First-Order-RoboCup-SSL/Dribbler_FOC_Driver/README.md

# Dribbler_FOC_Driver
FOC Driver

Version 1
