First-Order-RoboCup-SSL/Dribbler_FOC_Driver/dribbler_driver_ver.6/foc_driver_BOM.xlsx

Sheet: RLC
Reference | Value | Datasheet | Footprint | Qty | DNP
C1,C29,C40 | 100uF | ~ | Capacitor_SMD:C_0603_1608Metric_Pad1.08x0.95mm_HandSolder | 3
C2 | 1u | ~ | Capacitor_SMD:C_0603_1608Metric_Pad1.08x0.95mm_HandSolder | 1
C3,C4,C5,C6 | 0.01u | ~ | Capacitor_SMD:C_0603_1608Metric_Pad1.08x0.95mm_HandSolder | 4
C10,C11,C12,C13,C15,C19 | 4.7uF | ~ | Capacitor_SMD:C_0603_1608Metric_Pad1.08x0.95mm_HandSolder | 6
C14,C17,C22,C23,C24,C26,C36,C38,C39 | 100nF | ~ | Capacitor_SMD:C_0603_1608Metric_Pad1.08x0.95mm_HandSolder | 9
C16 | 1uF | ~ | Capacitor_SMD:C_0603_1608Metric_Pad1.08x0.95mm_HandSolder | 1
C18,C20,C25,C27 | 10u | ~ | Capacitor_SMD:C_0603_1608Metric_Pad1.08x0.95mm_HandSolder | 4
C21,C28 | 20pF | ~ | Capacitor_SMD:C_0603_1608Metric_Pad1.08x0.95mm_HandSolder | 2
C34,C35,C41,C42 | 10uF | ~ | Capacitor_SMD:C_0603_1608Metric_Pad1.08x0.95mm_HandSolder | 4
C37 | 30pF | ~ | Capacitor_SMD:C_0603_1608Metric_Pad1.08x0.95mm_HandSolder | 1
R1 | 0 |  | Resistor_SMD:R_0603_1608Metric_Pad0.98x0.95mm_HandSolder | 1
R2,R4,R6 | 4.7k | ~ | Resistor_SMD:R_0603_1608Metric_Pad0.98x0.95mm_HandSolder | 3
R3,R5,R9 | 100 | ~ | Resistor_SMD:R_0603_1608Metric_Pad0.98x0.95mm_HandSolder | 3
R7,R8 | 0.01 | ~ | Resistor_SMD:R_0603_1608Metric_Pad0.98x0.95mm_HandSolder | 2
R10 | 1k | ~ | Resistor_SMD:R_0603_1608Metric_Pad0.98x0.95mm_HandSolder | 1
R11,R12,R13,R14,R15,R20 | 2.2 | ~ | Resistor_SMD:R_0603_1608Metric_Pad0.98x0.95mm_HandSolder | 6
R16,R17,R21,R22,R23,R24,R28,R29,R30 | 10k | ~ | Resistor_SMD:R_0603_1608Metric_Pad0.98x0.95mm_HandSolder | 9
R18 | 120 | ~ | Resistor_SMD:R_0603_1608Metric_Pad0.98x0.95mm_HandSolder | 1
R19 | 470 | ~ | Resistor_SMD:R_0603_1608Metric_Pad0.98x0.95mm_HandSolder | 1
R25 | 100k | ~ | Resistor_SMD:R_0603_1608Metric_Pad0.98x0.95mm_HandSolder | 1
R26 | 47k | ~ | Resistor_SMD:R_0603_1608Metric_Pad0.98x0.95mm_HandSolder | 1
R27 | 249k | ~ | Resistor_SMD:R_0603_1608Metric_Pad0.98x0.95mm_HandSolder | 1
RN2 | R_Pack04_SIP_Split | http://www.vishay.com/docs/31509/csc.pdf | R_array_4:0402*4_r | 1
L2 | 15uH | ~ | Inductor_SMD:L_Neosid_SM-NE127_HandSoldering | 1

Sheet: MOS&Diode
Reference | Value | Datasheet | Footprint | Qty | DNP
D2, D6 | LED |  | LED_SMD:LED_0603_1608Metric_Pad1.05x0.95mm_HandSolder | 2
D1 | BZT52B20-G |  | Diode_SMD:D_SOD-123 | 1
D3, D4, D5 | 1N5819WS |  | Diode_SMD:D_SOD-323 | 3
Q1,Q2,Q5,Q6,Q9,Q10 | WSD4070DN |  | Package_DFN_QFN:DFN-8-1EP_3x3mm_P0.5mm_EP1.65x2.38mm | 6

Sheet: Connector
Reference | Value | Datasheet | Footprint | Qty | DNP
P1 | GH1.25-8 |  | Connector_JST:JST_GH_BM02B-GHS-TBT_1x02-1MP_P1.25mm_Vertical | 1
J1 | SWD_Debug |  | Connector_PinHeader_2.54mm:PinHeader_1x05_P2.54mm_Vertical | 1
J3,J4 | Conn_01x02_MountingPin |  | Connector_JST:JST_GH_BM02B-GHS-TBT_1x02-1MP_P1.25mm_Vertical | 2
JP1 | SolderJumper_2_Open |  | Jumper:SolderJumper-2_P1.3mm_Open_RoundedPad1.0x1.5mm | 1
USART1 | GH1.25-3 |  | Connector_PinHeader_2.54mm:PinHeader_1x03_P2.54mm_Vertical | 1

Sheet: MCU
Reference | Value | Datasheet | Footprint | Qty | DNP
RY8411 |  |  | SOT-23-6 | 1
U1 | STM32F103C8Tx | http://www.st.com/st-web-ui/static/active/en/resource/technical/document/datasheet/CD00161566.pdf | Package_QFP:LQFP-48_7x7mm_P0.5mm | 1
U2,U3 | INA240A2PWR |  | SCH_DengFO-easyedapro:TSSOP-8_L4.4-W3.0-P0.65-LS6.4-BL | 2
U5 | SIT1042T | http://www.ti.com/lit/ds/symlink/tcan337.pdf | Package_SO:SOP-8_3.9x4.9mm_P1.27mm | 1
U6 | XC6210B332MR | https://www.torexsemi.com/file/xc6210/XC6210.pdf | Package_TO_SOT_SMD:SOT-23-5 | 1
U8 | EG2133 |  | TSSOP-20 | 1
Y1 | Crystal 8MHz 20pf | ~ | Crystal:Crystal_SMD_5032-2Pin_5.0x3.2mm_HandSoldering | 1
