First-Order-RoboCup-SSL/Dribbler_FOC_Driver/dribbler_driver_ver.6/JST - PH - SMD (R) - 8Pin - 2.00mm.stp

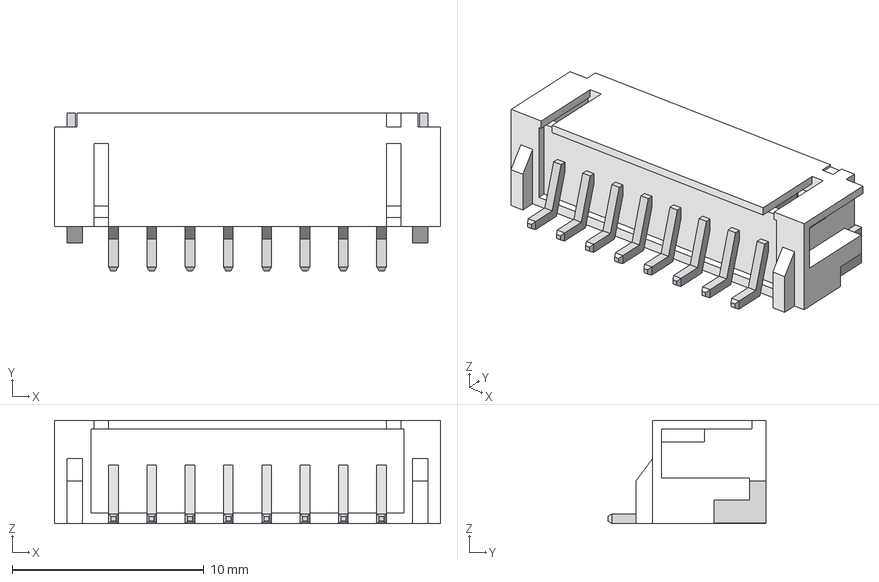
[picture p1: CAD file, 2026-01-09]
dribbler_driver_ver.6/JST - PH - SMD (R) - 8Pin - 2.00mm.stp
20.1 x 8.26 x 5.38 mm
