First-Order-RoboCup-SSL/Dribbler_FOC_Driver/dribbler_driver_ver.6/dribbler_driver.step

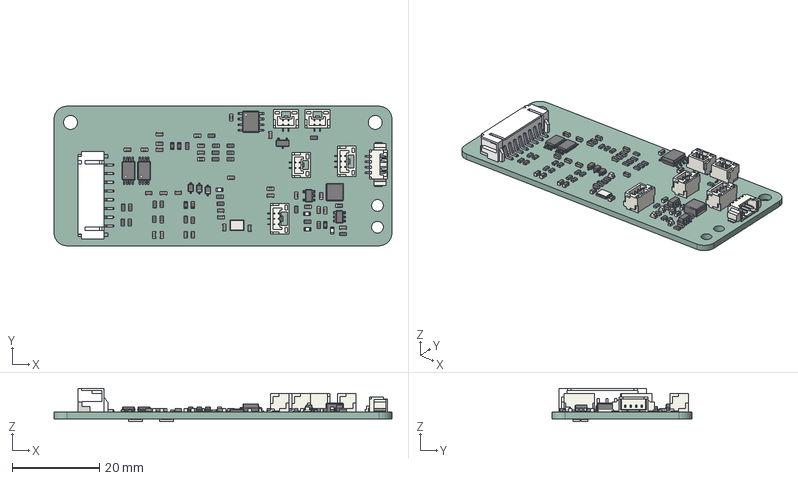
[picture p2: CAD file, 2026-01-09]
dribbler_driver_ver.6/dribbler_driver.step
77.7 x 32.1 x 7.61 mm
C_0603_1608Metric x 32
D_SOD-323 x 3
R_0603_1608Metric x 30
JST_GH_BM02B-GHS-TBT_1x02-1MP_P1.25mm_Vertical x 3
SOT-23-6
SOT-23
TSSOP-8_4.4x3mm_P0.65mm x 2
SOT-23-5
JST - PH - SMD (R) - 8Pin - 2.00mm
Molex_PicoBlade_53261-0471_1x04-1MP_P1.25mm_Horizontal
JST_GH_BM03B-GHS-TBT_1x03-1MP_P1.25mm_Vertical x 2
L_Changjiang_FNR4020S
LED_0603_1608Metric x 4
SOIC-8_3.9x4.9mm_P1.27mm
Crystal_SMD_3225-4Pin_3.2x2.5mm
R_1206_3216Metric x 2
dribbler_driver_PCB
