First-Order-RoboCup-SSL/Dribbler_FOC_Driver/(list of files, cad)

Other CAD files:
dribbler_driver_ver.6/dribbler_driver.DXF
