First-Order-RoboCup-SSL/Dribbler_FOC_Driver/(list of files, drawings)

Other design files:
Original_DENG_FOC/PCB_DengFOC V3PRO.epro
Original_DENG_FOC/SCH_DengFOC V3 pro.epro
