First-Order-RoboCup-SSL/Dribbler_FOC_Driver/dribbler_driver_ver.6/dribbler_driver.kicad_pcb

## KiCad design dribbler_driver_ver.6/dribbler_driver.kicad_pcb (2026-01-09)

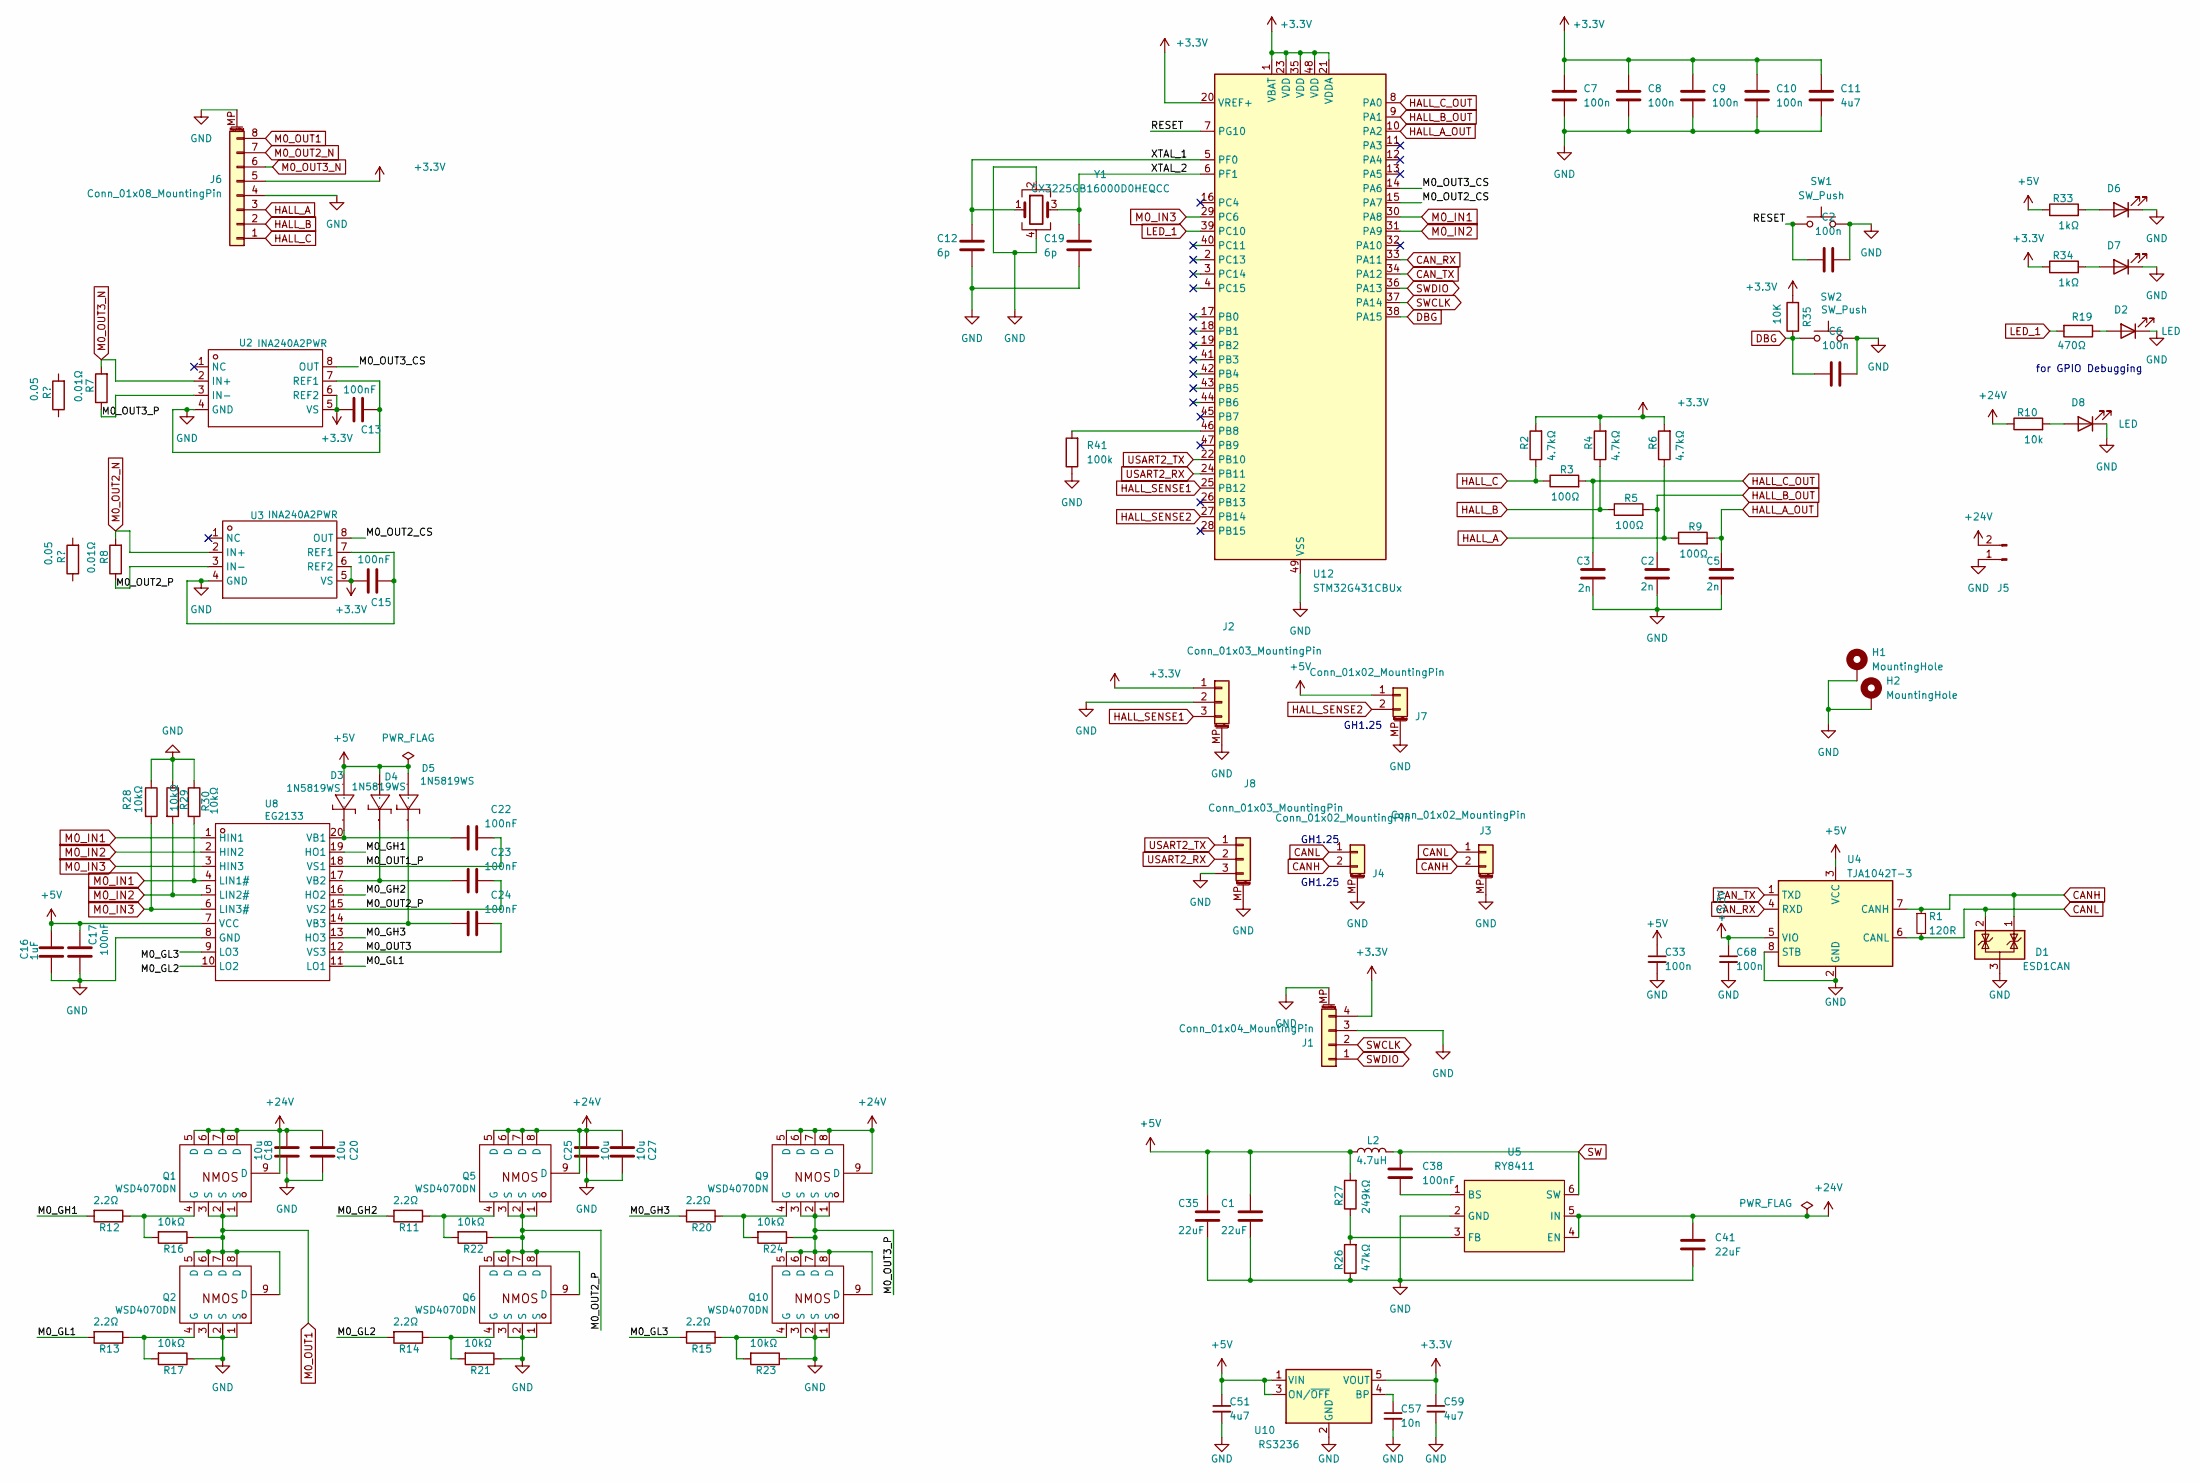
[picture p3: schematic dribbler_driver.kicad_sch, Dribbler FOC Driver]

Parts:
C1, C35, C41: 22uF; C_0603_1608Metric_Pad1.08x0.95mm_HandSolder
C2, C6, C7, C8, C9, C10, C33, C68: 100n; C_0603_1608Metric
C3, C5: 2n; C_0603_1608Metric_Pad1.08x0.95mm_HandSolder
C11, C51, C59: 4u7; C_0603_1608Metric
C12, C19: 6p; C_0603_1608Metric
C13, C15, C17, C22, C23, C24, C38: 100nF; C_0603_1608Metric_Pad1.08x0.95mm_HandSolder
C16: 1uF; C_0603_1608Metric_Pad1.08x0.95mm_HandSolder
C18, C20, C25, C27: 10u; C_0603_1608Metric_Pad1.08x0.95mm_HandSolder
C57: 10n; C_0603_1608Metric
D1: ESD1CAN; SOT-23
D2, D6, D7, D8: LED; LED_0603_1608Metric_Pad1.05x0.95mm_HandSolder
D3, D4, D5: 1N5819WS; D_SOD-323_HandSoldering; Manufacturer Part 1N5819WS
H1, H2: MountingHole; MountingHole_3.2mm_M3_Pad
J1: Conn_01x04_MountingPin; Molex_PicoBlade_53261-0471_1x04-1MP_P1.25mm_Horizontal
J2, J8: Conn_01x03_MountingPin; JST_GH_BM03B-GHS-TBT_1x03-1MP_P1.25mm_Vertical
J3, J4, J7: Conn_01x02_MountingPin; JST_GH_BM02B-GHS-TBT_1x02-1MP_P1.25mm_Vertical
J5: Conn_01x02_Pin; AMASS_XT30U-M_1x02_P5.0mm_Vertical
J6: Conn_01x08_MountingPin; JST_PH_S8B-PH-SM4-TB_1x08-1MP_P2.00mm_Horizontal
L2: 4.7uH; L_Changjiang_FNR4020S
Q1, Q2, Q5, Q6, Q9, Q10: WSD4070DN; DFN-8-1EP_3x3mm_P0.5mm_EP1.65x2.38mm; Manufacturer Part WSD4070DN
R1: 120R; R_0603_1608Metric
R2, R4, R6: 4.7kΩ; R_0603_1608Metric_Pad0.98x0.95mm_HandSolder
R3, R5, R9: 100Ω; R_0603_1608Metric_Pad0.98x0.95mm_HandSolder
R7, R8: 0.01Ω; R_1206_3216Metric
R10: 10k; R_0603_1608Metric_Pad0.98x0.95mm_HandSolder
R11, R12, R13, R14, R15, R20: 2.2Ω; R_0603_1608Metric_Pad0.98x0.95mm_HandSolder
R16, R17, R21, R22, R23, R24, R28, R29, R30: 10kΩ; R_0603_1608Metric_Pad0.98x0.95mm_HandSolder
R19: 470Ω; R_0603_1608Metric_Pad0.98x0.95mm_HandSolder
R26: 47kΩ; R_0603_1608Metric_Pad0.98x0.95mm_HandSolder
R27: 249kΩ; R_0603_1608Metric_Pad0.98x0.95mm_HandSolder
R33, R34: 1kΩ; R_0603_1608Metric_Pad0.98x0.95mm_HandSolder
R35: 10K; R_0603_1608Metric_Pad0.98x0.95mm_HandSolder
R41: 100k; R_0603_1608Metric
SW1, SW2: SW_Push; SW_SPST_SKQG_WithoutStem
U2, U3: INA240A2PWR; TSSOP-8_4.4x3mm_P0.65mm; Manufacturer Part INA240A2PWR
U4: TJA1042T-3; SOIC-8_3.9x4.9mm_P1.27mm
U5: RY8411; SOT-23-6_Handsoldering
U8: EG2133; TSSOP-20-1EP_4.4x6.5mm_P0.65mm_EP2.15x3.35mm; Manufacturer Part EG2133
U10: RS3236; SOT-23-5
U12: STM32G431CBUx; QFN-48-1EP_7x7mm_P0.5mm_EP5.6x5.6mm
Y1: CX3225GB16000D0HEQCC; Crystal_SMD_3225-4Pin_3.2x2.5mm

Connections:
+3.3V: C7.1, C8.1, C9.1, C10.1, C11.1, C13.1, C15.1, C59.1, C68.1, J1.4, J2.1, J6.5, R2.2, R4.2, R6.2, R34.1, R35.2, U2.5 (VS), U2.6 (REF2), U3.5 (VS), U3.6 (REF2), U4.5 (VIO), U10.5 (VOUT), U12.1 (VBAT), U12.20 (VREF+), U12.21 (VDDA), U12.23 (VDD), U12.35 (VDD), U12.48 (VDD)
+5V: C1.1, C16.1, C17.1, C33.1, C35.1, C51.1, D3.2 (A), D4.2 (A), D5.2 (A), J7.1, L2.1, R27.2, R33.1, U4.3 (VCC), U8.7 (VCC), U10.1 (VIN), U10.3 (ON/~OFF)
+24V: C18.1, C20.1, C25.1, C27.1, C41.1, J5.2, Q1.5 (D), Q1.6 (D), Q1.7 (D), Q1.8 (D), Q1.9 (D), Q5.5 (D), Q5.6 (D), Q5.7 (D), Q5.8 (D), Q5.9 (D), Q9.5 (D), Q9.6 (D), Q9.7 (D), Q9.8 (D), Q9.9 (D), R10.1, U5.4 (EN), U5.5 (IN)
/M0_GH1: R12.2, U8.19 (HO1)
/M0_GH2: R11.2, U8.16 (HO2)
/M0_GH3: R20.2, U8.13 (HO3)
/M0_GL1: R13.2, U8.11 (LO1)
/M0_GL2: R14.2, U8.10 (LO2)
/M0_GL3: R15.2, U8.9 (LO3)
/M0_OUT1_P: C22.1, U8.18 (VS1)
/M0_OUT2_CS: U3.8 (OUT), U12.15 (PA7)
/M0_OUT2_P: C23.1, Q5.1 (S), Q5.2 (S), Q5.3 (S), Q6.5 (D), Q6.6 (D), Q6.7 (D), Q6.8 (D), Q6.9 (D), R8.1, R22.1, U3.3 (IN-), U8.15 (VS2)
/M0_OUT3: C24.1, U8.12 (VS3)
/M0_OUT3_CS: U2.8 (OUT), U12.14 (PA6)
/M0_OUT3_P: Q9.1 (S), Q9.2 (S), Q9.3 (S), Q10.5 (D), Q10.6 (D), Q10.7 (D), Q10.8 (D), Q10.9 (D), R7.1, R24.1, U2.3 (IN-)
/XTAL_1: C12.1, U12.5 (PF0), Y1.1
/XTAL_2: C19.1, U12.6 (PF1), Y1.3
CANH: D1.1 (K), J3.2, J4.2, R1.1, U4.7 (CANH)
CANL: D1.2 (K), J3.1, J4.1, R1.2, U4.6 (CANL)
CAN_RX: U4.4 (RXD), U12.33 (PA11)
CAN_TX: U4.1 (TXD), U12.34 (PA12)
DBG: C6.1, R35.1, SW2.1, U12.38 (PA15)
GND: C1.2, C2.2, C3.1, C5.2, C6.2, C7.2, C8.2, C9.2, C10.2, C11.2, C12.2, C13.2, C15.2, C16.2, C17.2, C18.2, C19.2, C20.2, C25.2, C27.2, C33.2, C35.2, C41.2, C51.2, C57.2, C59.2, C68.2, D1.3 (A), D2.1 (K), D6.1 (K), D7.1 (K), D8.1 (K), H1.1, H2.1, J1.3, J1.MP (MountPin), J2.2, J2.MP (MountPin), J3.MP (MountPin), J4.MP (MountPin), J5.1, J6.4, J6.MP (MountPin), J7.MP (MountPin), J8.3, J8.MP (MountPin), Q2.1 (S), Q2.2 (S), Q2.3 (S), Q6.1 (S), Q6.2 (S), Q6.3 (S), Q10.1 (S), Q10.2 (S), Q10.3 (S), R17.1, R21.1, R23.1, R26.1, R28.1, R29.1, R30.1, R41.1, SW1.2, SW2.2, U2.4 (GND), U2.7 (REF1), U3.4 (GND), U3.7 (REF1), U4.2 (GND), U4.8 (STB), U5.2 (GND), U8.8 (GND), U8.21, U10.2 (GND), U12.49 (VSS), Y1.2, Y1.4; also elsewhere on the board
HALL_A: J6.3, R6.1, R9.1
HALL_A_OUT: C5.1, R9.2, U12.10 (PA2)
HALL_B: J6.2, R4.1, R5.1
HALL_C: J6.1, R2.1, R3.1
HALL_C_OUT: C3.2, R3.2, U12.8 (PA0)
HALL_SENSE1: J2.3, U12.25 (PB12)
HALL_SENSE2: J7.2, U12.27 (PB14)
LED_1: R19.2, U12.39 (PC10)
M0_IN1: R30.2, U8.1 (HIN1), U8.4 (LIN1#), U12.30 (PA8)
M0_IN2: R29.2, U8.2 (HIN2), U8.5 (LIN2#), U12.31 (PA9)
M0_IN3: R28.2, U8.3 (HIN3), U8.6 (LIN3#), U12.29 (PC6)
M0_OUT1: J6.8, Q1.1 (S), Q1.2 (S), Q1.3 (S), Q2.5 (D), Q2.6 (D), Q2.7 (D), Q2.8 (D), Q2.9 (D), R16.1
M0_OUT2_N: J6.7, R8.2, U3.2 (IN+)
M0_OUT3_N: J6.6, R7.2, U2.2 (IN+)
unnamed: D2.2 (A), R19.1
unnamed: C22.2, D3.1 (C), U8.20 (VB1)
unnamed: C23.2, D4.1 (C), U8.17 (VB2)
unnamed: C24.2, D5.1 (C), U8.14 (VB3)
unnamed: D6.2 (A), R33.2
unnamed: D7.2 (A), R34.2
unnamed: D8.2 (A), R10.2
unnamed: Q1.4 (G), R12.1, R16.2
unnamed: Q2.4 (G), R13.1, R17.2
unnamed: Q5.4 (G), R11.1, R22.2
unnamed: Q6.4 (G), R14.1, R21.2
unnamed: Q9.4 (G), R20.1, R24.2
unnamed: Q10.4 (G), R15.1, R23.2
unnamed: C38.2, U5.1 (BS)
unnamed: R26.2, R27.1, U5.3 (FB)
unnamed: C57.1, U10.4 (BP)
unnamed: R41.2, U12.46 (PB8)
SW: C38.1, L2.2, U5.6 (SW)
SWCLK: J1.2, U12.37 (PA14)
SWDIO: J1.1, U12.36 (PA13)
USART2_RX: J8.2, U12.24 (PB11)
USART2_TX: J8.1, U12.22 (PB10)

Notes on the sheet:
GH1.25
for GPIO Debugging

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
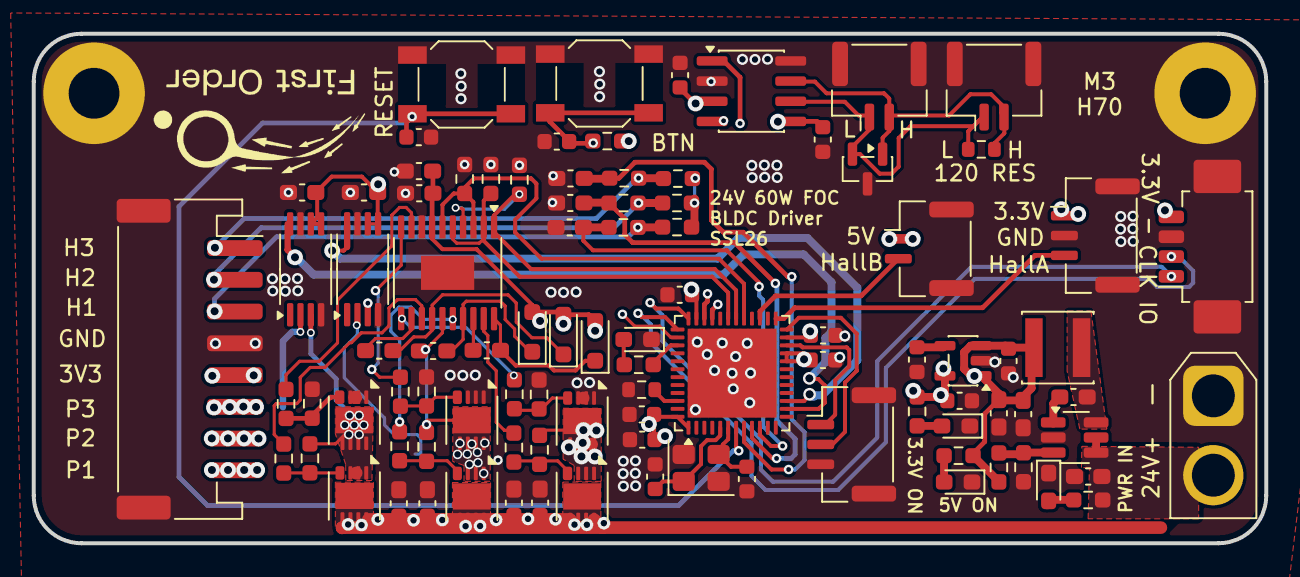
[picture p4: board dribbler_driver.kicad_pcb from above]

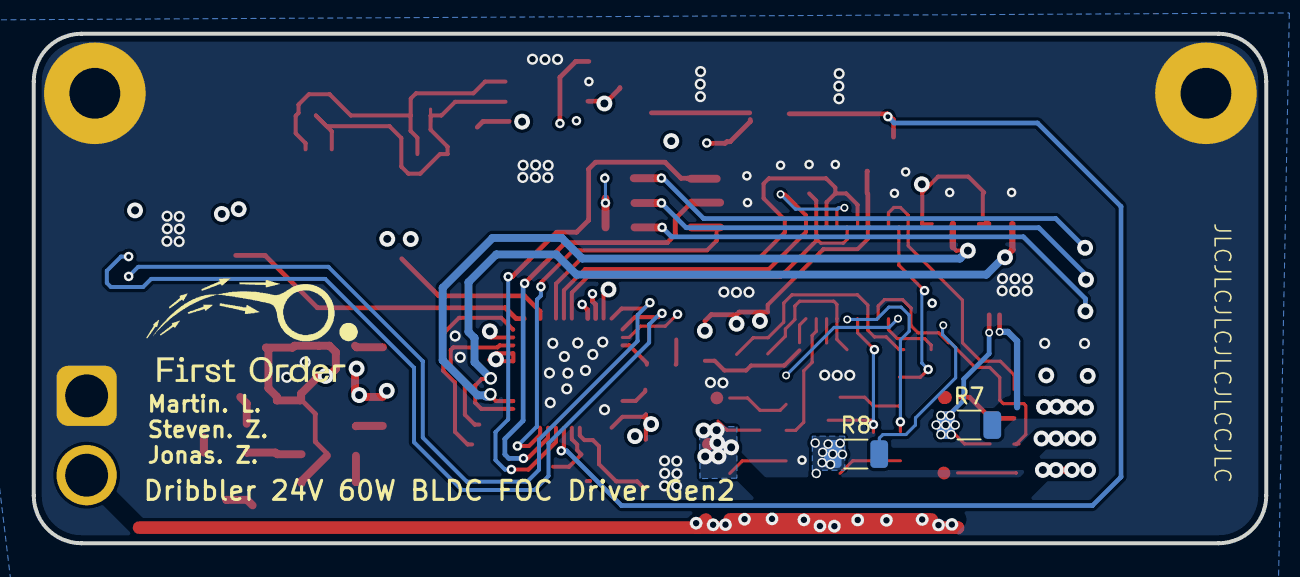
[picture p5: board dribbler_driver.kicad_pcb from below]

Board: 4 copper layers, 77.7 x 32.1 mm, 99 parts (2 on the bottom side), 61 nets.

Other parts of the board:
C4: 0.01u; C_0603_1608Metric_Pad1.08x0.95mm_HandSolder

Their connections:
GND: C4.2; also elsewhere on the board
