First-Order-RoboCup-SSL/Dribbler_FOC_Driver/Original_DENG_FOC/SCH_DengFOC V3 pro/SCH_DengFOC V3 pro.kicad_pcb

## KiCad design Original_DENG_FOC/SCH_DengFOC V3 pro/SCH_DengFOC V3 pro.kicad_pcb (2025-11-01)

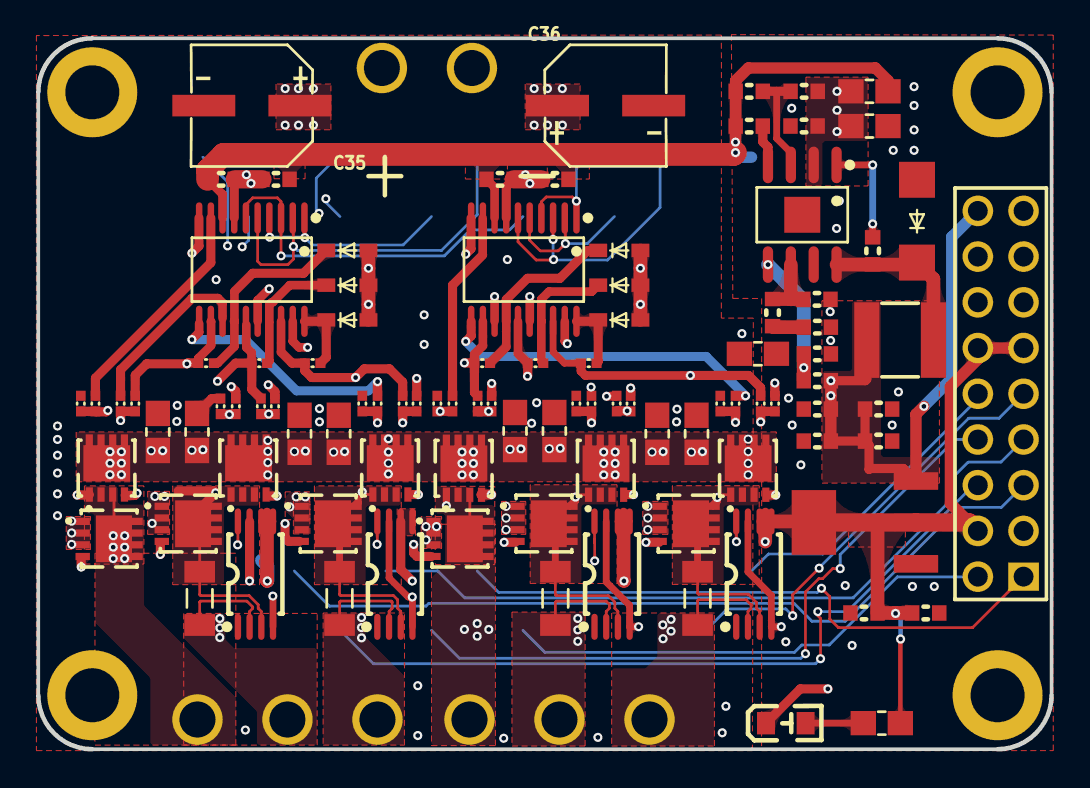
[picture p6: board SCH_DengFOC V3 pro.kicad_pcb from above]

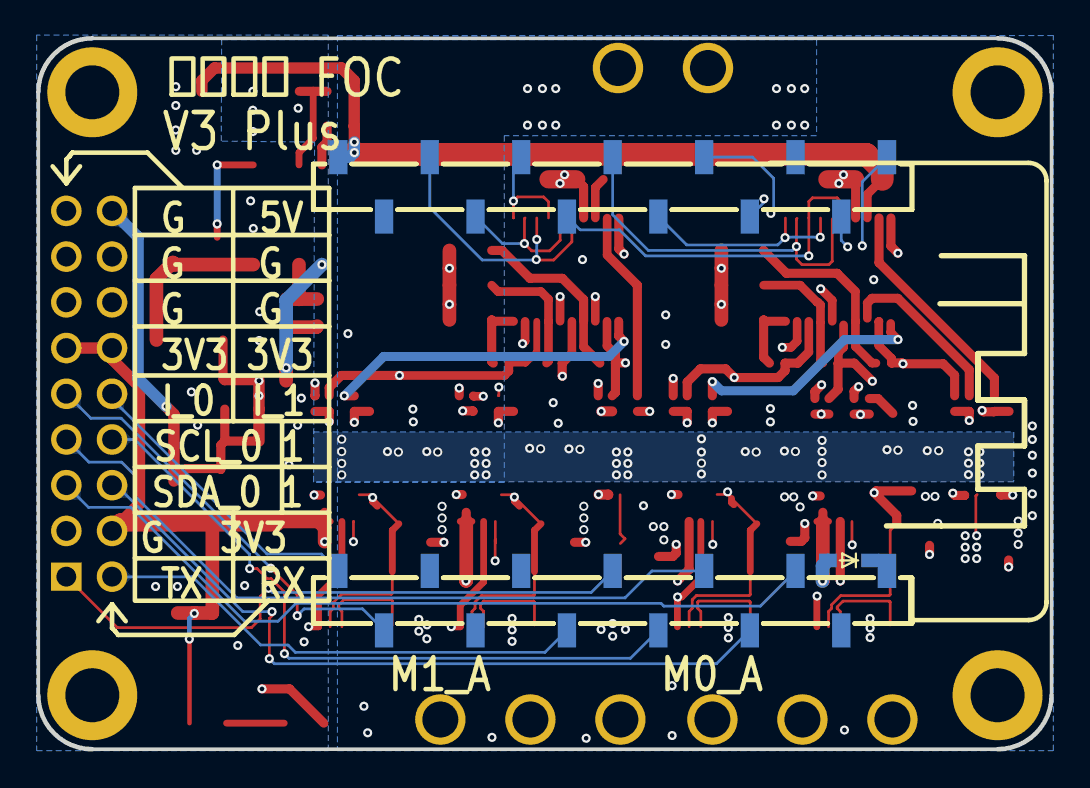
[picture p7: board SCH_DengFOC V3 pro.kicad_pcb from below]

Board: 4 copper layers, 56.3 x 39.5 mm, 102 parts (4 on the bottom side), 72 nets.

Parts:
C1, C2, C4, C5, C10, C12, C14, C15, C17, C24, C26, C27, C28, C33, C34: 0603
C3, C7, C8, C11, C18, C19, C25, C30, C31, C32: 0805
C9, C13, C16, C21, C23, C29: 0402
C35, C36: CAP-SMD_BD6.3-L6.6-W6.6-LS7.4-FD
D2: DO-214AC_L4.3-W2.7-LS5.3-RD
D4, D6, D7, D8, D9, D10, D11: SOD-323_L1.8-W1.3-LS2.5-RD
H1: HDR-TH_18P-P2.54-V-R2-C9-S2.54
H2, H3: SMD,P=2.54mm(交错脚)
L1: IND-SMD_L5.0-W5.0_SWPA5040S
LED1: LED0805-RD
Q1, Q2, Q3, Q4, Q5, Q6, Q7, Q8, Q9, Q10, Q11, Q12: PDFN3333-8_L3.1-W3.2-P0.65-LS3.4-BL
R2, R3: 0805
R4, R5, R6, R9, R10: 0603
R11, R12, R13, R14, R20, R21, R22, R23, R24, R25, R26, R27: 0402
R15, R16, R17, R18: R1206
R28, R29, R30, R31, R32, R33, R34, R35, R36, R37, R38, R39: R0402
U2: MICROPYTHON ESP32
U3: SOIC-8_L5.0-W4.0-P1.27-LS6.0-BL-EP
U5, U11: TSSOP-20_L6.5-W4.4-P0.65-LS6.4-BL
U6, U7, U8, U9: TSSOP-8_L4.4-W3.0-P0.65-LS6.4-BL
U10: SOT-223-4_L6.5-W3.5-P2.30-LS7.0-BR

Connections:
3V3: C26.1, C28.2, D11.2, H1.4, H1.11, H1.12, R3.1, U6.5, U6.6, U7.5, U7.6, U8.5, U8.6, U9.5, U9.6, U10.2, U10.4
5V: C1.2, C2.2, C4.1, C5.1, C24.1, C27.2, C33.2, C34.2, D4.2, D6.2, D7.2, D8.2, D9.2, D10.2, H1.18, L1.2, R9.2, U5.7, U10.3, U11.7
$1N75: LED1.2, R3.2
$1N530: R9.1, R10.2, U3.5
$1N531: C17.1, D2.1, L1.1, U3.8
$1N532: C17.2, U3.1
$1N535: C14.2, C15.2, U3.6
$1N536: C12.2, U3.4
$1N538: R4.1, R5.2, U3.3
$1N1312: C23.1, D9.1, U11.17
$1N1315: C29.1, D8.1, U11.14
$1N1336: C21.1, D10.1, U11.20
$1N1359: C9.1, D4.1, U5.20
$1N1370: C16.1, D7.1, U5.14
$1N1373: C13.1, D6.1, U5.17
$1N1444: C14.1, R6.2
$1N6010: Q7.4, R14.2, R34.1
$1N6048: Q8.4, R13.2, R35.1
$1N6067: Q9.4, R11.2, R36.1
$1N6091: Q10.4, R12.2, R37.1
$1N6102: Q12.4, R20.2, R38.1
$1N6136: Q11.4, R21.2, R39.1
$1N6143: Q6.4, R23.2, R33.1
$1N6154: Q5.4, R22.2, R32.1
$1N6178: Q4.4, R25.2, R30.1
$1N6189: Q3.4, R24.2, R31.1
$1N6225: Q2.4, R26.2, R29.1
$1N6232: Q1.4, R27.2, R28.1
$1N7980: D11.1, H2.1
GND: C1.1, C2.1, C3.1, C4.2, C5.2, C8.1, C10.2, C12.1, C15.1, C24.2, C26.2, C27.1, C28.1, C33.1, C34.1, D2.2, H1.3, H1.13, H1.14, H1.15, H1.16, H1.17, H3.13, LED1.1, R2.2, R5.1, R6.1, R10.1, U3.7, U3.9, U5.8, U6.4, U6.7, U7.4, U7.7, U8.4, U8.7, U9.4, U9.7, U10.1, U11.8
I_0: H1.9, H2.12
I_1: H1.10, H2.13
M0_GH1: R27.1, U11.19
M0_GH2: R24.1, U11.16
M0_GH3: R22.1, U11.13
M0_GL1: R26.1, U11.11
M0_GL2: R25.1, U11.10
M0_GL3: R23.1, U11.9
M0_IN1: H3.6, U11.1, U11.4
M0_IN2: H3.7, U11.2, U11.5
M0_IN3: H3.8, U11.3, U11.6
M0_OUT1_CS: H3.2, U6.8
M0_OUT1_N: R15.2, U6.2
M0_OUT1_P: C21.2, Q1.1, Q1.2, Q1.3, Q2.5, Q2.6, Q2.7, Q2.8, Q2.9, R15.1, R28.2, U6.3, U11.18
M0_OUT2_CS: H3.1, U7.8
M0_OUT2_N: R16.2, U7.2
M0_OUT2_P: C23.2, Q3.1, Q3.2, Q3.3, Q4.5, Q4.6, Q4.7, Q4.8, Q4.9, R16.1, R31.2, U7.3, U11.15
M0_OUT3: C29.2, Q5.1, Q5.2, Q5.3, Q6.5, Q6.6, Q6.7, Q6.8, Q6.9, R32.2, U11.12
M1_GH1: R14.1, U5.19
M1_GH2: R11.1, U5.16
M1_GH3: R21.1, U5.13
M1_GL1: R13.1, U5.11
M1_GL2: R12.1, U5.10
M1_GL3: R20.1, U5.9
M1_IN1: H3.9, U5.1, U5.4
M1_IN2: H3.10, U5.2, U5.5
M1_IN3: H3.11, U5.3, U5.6
M1_OUT1_CS: H3.5, U8.8
M1_OUT1_N: R17.2, U8.2
M1_OUT1_P: C9.2, Q7.1, Q7.2, Q7.3, Q8.5, Q8.6, Q8.7, Q8.8, Q8.9, R17.1, R34.2, U5.18, U8.3
M1_OUT2_CS: H3.4, U9.8
M1_OUT2_N: R18.2, U9.2
M1_OUT2_P: C13.2, Q9.1, Q9.2, Q9.3, Q10.5, Q10.6, Q10.7, Q10.8, Q10.9, R18.1, R36.2, U5.15, U9.3
M1_OUT3: C16.2, Q11.1, Q11.2, Q11.3, Q12.5, Q12.6, Q12.7, Q12.8, Q12.9, R39.2, U5.12
PGND: C7.1, C11.1, C18.1, C19.1, C25.1, C30.1, C31.1, C32.1, C35.2, C36.2, Q2.1, Q2.2, Q2.3, Q4.1, Q4.2, Q4.3, Q6.1, Q6.2, Q6.3, Q8.1, Q8.2, Q8.3, Q10.1, Q10.2, Q10.3, Q12.1, Q12.2, Q12.3, R2.1, R29.2, R30.2, R33.2, R35.2, R37.2, R38.2
RXD: H1.2, H2.8
SCL_0: H1.7, H2.5
SCL_1: H1.8, H2.6
SDA_0: H1.5, H2.3
SDA_1: H1.6, H2.4
TXD: H1.1, H2.7
VIN: C3.2, C7.2, C8.2, C10.1, C11.2, C18.2, C19.2, C25.2, C30.2, C31.2, C32.2, C35.1, C36.1, Q1.5, Q1.6, Q1.7, Q1.8, Q1.9, Q3.5, Q3.6, Q3.7, Q3.8, Q3.9, Q5.5, Q5.6, Q5.7, Q5.8, Q5.9, Q7.5, Q7.6, Q7.7, Q7.8, Q7.9, Q9.5, Q9.6, Q9.7, Q9.8, Q9.9, Q11.5, Q11.6, Q11.7, Q11.8, Q11.9, R4.2, U3.2
