First-Order-RoboCup-SSL/Dribbler_FOC_Driver/dribbler_driver_ver.6/changelog.txt

DCDC：删除多余电容，修改电感为0420 4.7uH贴片屏蔽电感
SIT1042T：SPLIT焊点删除。
电流传感器增加去耦电容，网络修改为2，3路，因为PCB布线方便
STM32修改四颗4.7uF为100nF，并增加一颗4.7uF
