First-Order-RoboCup-SSL/Dribbler_FOC_Driver/Dribbler_Board_Embedded/Dribbler_Board_Embedded.ioc

Mcu.UserName=STM32G431CBUx
PA0.Signal=S_TIM2_CH1
PA1.Signal=S_TIM2_CH2
PA11.Signal=FDCAN1_RX
PA12.Signal=FDCAN1_TX
PA13.Signal=SYS_JTMS-SWDIO
PA14.Signal=SYS_JTCK-SWCLK
PA15.Signal=GPIO_Input
PA2.Signal=S_TIM2_CH3
PA6.Signal=ADC2_IN3
PA7.Signal=ADC2_IN4
PA8.Signal=GPIO_Output
PA9.Signal=GPIO_Output
PB10.Signal=USART3_TX
PB11.Signal=USART3_RX
PB12.Signal=ADC1_IN11
PB14.Signal=ADC1_IN5
PB8-BOOT0.GPIO_Label=Boot_Input
PB8-BOOT0.Signal=GPIO_Input
PC10.Signal=GPIO_Input
PC6.Signal=GPIO_Output
PF0-OSC_IN.Signal=RCC_OSC_IN
PF1-OSC_OUT.Signal=RCC_OSC_OUT
PG10-NRST.GPIO_Label=NRST_Input
PG10-NRST.Signal=GPIO_Input
