First-Order-RoboCup-SSL/Dribbler_FOC_Driver/Dribbler_Board_Embedded/Core/Inc/main.h

#define NRST_Input_Pin GPIO_PIN_10
#define NRST_Input_GPIO_Port GPIOG
#define Boot_Input_Pin GPIO_PIN_8
#define Boot_Input_GPIO_Port GPIOB
