First-Order-RoboCup-SSL/Dribbler_FOC_Driver/(commit log)

2025-03-21 Version 1 foc driver
    [dribbler_driver.kicad_pcb, dribbler_driver.kicad_sch]
2025-03-29 fixed stm32 peripherals
    [dribbler_driver.kicad_sch]
2025-03-31 version 4 of hardware
    [dribbler_driver.kicad_pcb, dribbler_driver.kicad_sch, foc_driver_BOM.xlsx]
2025-04-02 updated pcb (GND network unprocessed)
    [dribbler_driver.kicad_pcb]
2025-04-02 updated RY8411 footprint
    [dribbler_driver.kicad_pcb]
2025-04-02 footprint RY8411 updated
    [dribbler_driver.kicad_pcb]
2025-11-01 clean up
    [PCB_DengFOC V3PRO.epro, SCH_DengFOC V3 pro.epro, SCH_DengFOC V3 pro.kicad_pcb, SCH_DengFOC V3 pro.kicad_sch, dribbler_driver.kicad_pcb, dribbler_driver.kicad_sch, foc_driver_BOM.xlsx]
2025-11-01 clean up and update IOC
    [dribbler_driver.kicad_sch]
2025-12-27 fix mosfet solderability, High current path issue, update MCU
    [bom.csv, designators.csv, dribbler_driver.DXF, dribbler_driver.kicad_pcb, dribbler_driver.kicad_sch, dribbler_driver.step, foc_driver_BOM.xlsx, positions.csv]
2026-01-09 gen 6 production
    [JST - PH - SMD (R) - 8Pin - 2.00mm.stp, dribbler_driver.kicad_pcb, dribbler_driver.kicad_sch, dribbler_driver.step]
