First-Order-RoboCup-SSL/Dribbler_FOC_Driver/(notices)

Notices in the files:
Dribbler_Board_Embedded/Core/Inc/main.h:
Copyright (c) 2025 STMicroelectronics.
All rights reserved.
This software is licensed under terms that can be found in the LICENSE file
